fabynardon/SigmaDelta/spice/sigmadelta test.asc

A1: dflop
A2: dflop
A3: dflop
C1: cap; 1n
C2: cap; 1n
C3: cap; 1n
C4: cap; 1n
C5: cap; 1n
R1: res; 500
R2: res; 1000
R3: res; 1000
R4: res; 500
R5: res; 500
R6: res; 500
U1: LTC6752
U2: LTC6752
U3: LTC6752
V2: voltage; PULSE(0 1 0 0 0 100u 200u)
V3: voltage; PULSE(0 3 0 0 0 10n 20n)
V4: voltage; 0.5
V6: voltage; 3
Named nets: 0, SDADC1, sdadc2, Comps, Clk, Vin, sdadc3, SDADC2FILT, SDADC3FILT, SDADC1FILT
.tran 1m
