fabynardon/SigmaDelta/spice/sigma delta.asc

A2: dflop
C2: cap; 1n
C3: cap; 1n
R2: res; 1k
R3: res; 1k
R4: res; 500
U1: LTC6752
V2: voltage; SINE(0.5 0.5 10000 0 0 0 0)
V3: voltage; PULSE(0 3 0 0 0 25n 50n)
V4: voltage; 0.5
V6: voltage; 3
Named nets: 0, Pulsos_Out, Comps, Clk, Vin, Signal, data_volt_in_p, Diff_Output
.tran 100u
