fabynardon/SigmaDelta/nexys2/scopeio/nexys2.vhd

library ieee;
use ieee.std_logic_1164.all;
use ieee.numeric_std.all;
use ieee.math_real.all;

library unisim;
use unisim.vcomponents.all;

library hdl4fpga;
use hdl4fpga.std.all;
use hdl4fpga.cgafont.all;

architecture beh of nexys2 is

	signal ser_clk    : std_logic;
	signal vga_clk    : std_logic;
	signal input_clk : std_logic;
	
	constant inputs : natural := 2;

	constant hz_scales : scale_vector(0 to 16-1) := (
		(from => 0.0, step => 2.50001*5.0*10.0**(-1), mult => 10**0*2**0*5**0, scale => "0001", deca => x"E6"),
		(from => 0.0, step => 5.00001*5.0*10.0**(-1), mult => 10**0*2**0*5**0, scale => "0010", deca => x"E6"),
                                                                                                 
		(from => 0.0, step => 1.00001*5.0*10.0**(+0), mult => 10**0*2**1*5**0, scale => "0100", deca => x"E6"),
		(from => 0.0, step => 2.50001*5.0*10.0**(+0), mult => 10**0*2**0*5**1, scale => "0101", deca => x"E6"),
		(from => 0.0, step => 5.00001*5.0*10.0**(+0), mult => 10**1*2**0*5**0, scale => "0110", deca => x"E6"),
                                                   
		(from => 0.0, step => 1.00001*5.0*10.0**(+1), mult => 10**1*2**1*5**0, scale => "1000", deca => x"E6"),
		(from => 0.0, step => 2.50001*5.0*10.0**(+1), mult => 10**1*2**0*5**1, scale => "1001", deca => x"E6"),
		(from => 0.0, step => 5.00001*5.0*10.0**(+1), mult => 10**2*2**0*5**0, scale => "1010", deca => x"E6"),
                                                   
		(from => 0.0, step => 1.00001*5.0*10.0**(-1), mult => 10**2*2**1*5**0, scale => "0000", deca => to_ascii('m')),
		(from => 0.0, step => 2.50001*5.0*10.0**(-1), mult => 10**2*2**0*5**1, scale => "0001", deca => to_ascii('m')),
		(from => 0.0, step => 5.00001*5.0*10.0**(-1), mult => 10**3*2**0*5**0, scale => "0010", deca => to_ascii('m')),

		(from => 0.0, step => 1.00001*5.0*10.0**(+0), mult => 10**3*2**1*5**0, scale => "0100", deca => to_ascii('m')),
		(from => 0.0, step => 2.50001*5.0*10.0**(+0), mult => 10**3*2**0*5**1, scale => "0101", deca => to_ascii('m')),
		(from => 0.0, step => 5.00001*5.0*10.0**(+0), mult => 10**4*2**0*5**0, scale => "0110", deca => to_ascii('m')),

		(from => 0.0, step => 1.00001*5.0*10.0**(+1), mult => 10**4*2**1*5**0, scale => "1000", deca => to_ascii('m')),
		(from => 0.0, step => 2.50001*5.0*10.0**(+1), mult => 10**4*2**0*5**1, scale => "1001", deca => to_ascii('m')));

	constant vt_scales : scale_vector(0 to 16-1) := (
		(from => 7*1.00001*10.0**(+1), step => -1.00001*10.0**(+1), mult => (100*2**18)/(128*10**0*2**1*5**0), scale => "1000", deca => to_ascii('m')),
		(from => 7*2.50001*10.0**(+1), step => -2.50001*10.0**(+1), mult => (100*2**18)/(128*10**0*2**0*5**1), scale => "1001", deca => to_ascii('m')),
		(from => 7*5.00001*10.0**(+1), step => -5.00001*10.0**(+1), mult => (100*2**18)/(128*10**0*2**1*5**1), scale => "1010", deca => to_ascii('m')),
                                                                                                                
		(from => 7*1.00001*10.0**(-1), step => -1.00001*10.0**(-1), mult => (100*2**18)/(128*10**1*2**1*5**0), scale => "0000", deca => to_ascii(' ')),
		(from => 7*2.50001*10.0**(-1), step => -2.50001*10.0**(-1), mult => (100*2**18)/(128*10**1*2**0*5**1), scale => "0001", deca => to_ascii(' ')),
		(from => 7*5.00001*10.0**(-1), step => -5.00001*10.0**(-1), mult => (100*2**18)/(128*10**1*2**1*5**1), scale => "0010", deca => to_ascii(' ')),
                                                                                                                
		(from => 7*1.00001*10.0**(+0), step => -1.00001*10.0**(+0), mult => (100*2**18)/(128*10**2*2**1*5**0), scale => "0100", deca => to_ascii(' ')),
		(from => 7*2.50001*10.0**(+0), step => -2.50001*10.0**(+0), mult => (100*2**18)/(128*10**2*2**0*5**1), scale => "0101", deca => to_ascii(' ')),
		(from => 7*5.00001*10.0**(+0), step => -5.00001*10.0**(+0), mult => (100*2**18)/(128*10**2*2**1*5**1), scale => "0110", deca => to_ascii(' ')),
                                                                                                                
		(from => 7*1.00001*10.0**(+1), step => -1.00001*10.0**(+1), mult => (100*2**18)/(128*10**3*2**1*5**0), scale => "1000", deca => to_ascii(' ')),
		(from => 7*2.50001*10.0**(+1), step => -2.50001*10.0**(+1), mult => (100*2**18)/(128*10**3*2**0*5**1), scale => "1001", deca => to_ascii(' ')),
		(from => 7*5.00001*10.0**(+1), step => -5.00001*10.0**(+1), mult => (100*2**18)/(128*10**3*2**1*5**1), scale => "1010", deca => to_ascii(' ')),
                                                                                                              
		(from => 7*1.00001*10.0**(-1), step => -1.00001*10.0**(-1), mult => (100*2**18)/(128*10**4*2**1*5**0), scale => "0000", deca => to_ascii('k')),
		(from => 7*2.50001*10.0**(-1), step => -2.50001*10.0**(-1), mult => (100*2**18)/(128*10**4*2**0*5**1), scale => "0001", deca => to_ascii('k')),
		(from => 7*5.00001*10.0**(-1), step => -5.00001*10.0**(-1), mult => (100*2**18)/(128*10**4*2**1*5**1), scale => "0010", deca => to_ascii('k')),
                                                                                                              
		(from => 7*1.00001*10.0**(+0), step => -1.00001*10.0**(+0), mult => (125*2**18)/(128*10**5*2**0*5**0), scale => "0100", deca => to_ascii('k')));
	
	COMPONENT MyDFS
	PORT(
		CLKIN_IN : IN std_logic;
		RST_IN : IN std_logic;          
		CLKFX_OUT : OUT std_logic;
		CLKIN_IBUFG_OUT : OUT std_logic;
		CLK0_OUT : OUT std_logic
		);
	END COMPONENT;
	
begin

	Inst_MyDFS: MyDFS PORT MAP(
		CLKIN_IN => xtal,
		RST_IN => '0',
		CLKFX_OUT => vga_clk,
		CLKIN_IBUFG_OUT => open,
		CLK0_OUT => ser_clk
	);
	
	scopeio_e : entity hdl4fpga.scopeio
	generic map (
		layout_id    => 1,
		hz_scales    => hz_scales,
		vt_scales    => vt_scales,
		input_preamp 	=> (0 to  1 => 1.0),
		inputs       => inputs,		--cantidad de entradas deseadas
		gauge_labels => to_ascii(string'(
			"Escala     : " &
			"Posicion   : " &
			"Escala     : " &
			"Posicion   : " &
			"Horizontal : " &
			"Disparo    : ")),
		unit_symbols => to_ascii(string'(
			"V" &
			"V" &
			"V" &
			"V" &
			"s" &
			"V")),
		channels_fg  => b"00000011" & b"11100000",	-- un string para cada canal
		channels_bg  => b"00000000" & b"00000000",
		hzaxis_fg    => b"00011100",
		hzaxis_bg    => b"00000000",
		grid_fg      => b"11100000",
		grid_bg      => b"00000000")
	port map (
		ser_clk 		=> ser_clk,
		ser_rx 		=> rs232_rxd,
		input_clk   => input_clk,
		input_data  => "00000000",
		video_clk   => vga_clk,
		video_rgb   => vga_rgb,
		video_hsync => vga_hs,
		video_vsync => vga_vs);

end;
